oclyke/Neptune/hardware/hubble-lens/hubble-lens.kicad_pcb

## KiCad design hardware/hubble-lens/hubble-lens.kicad_pcb (2025-04-26)

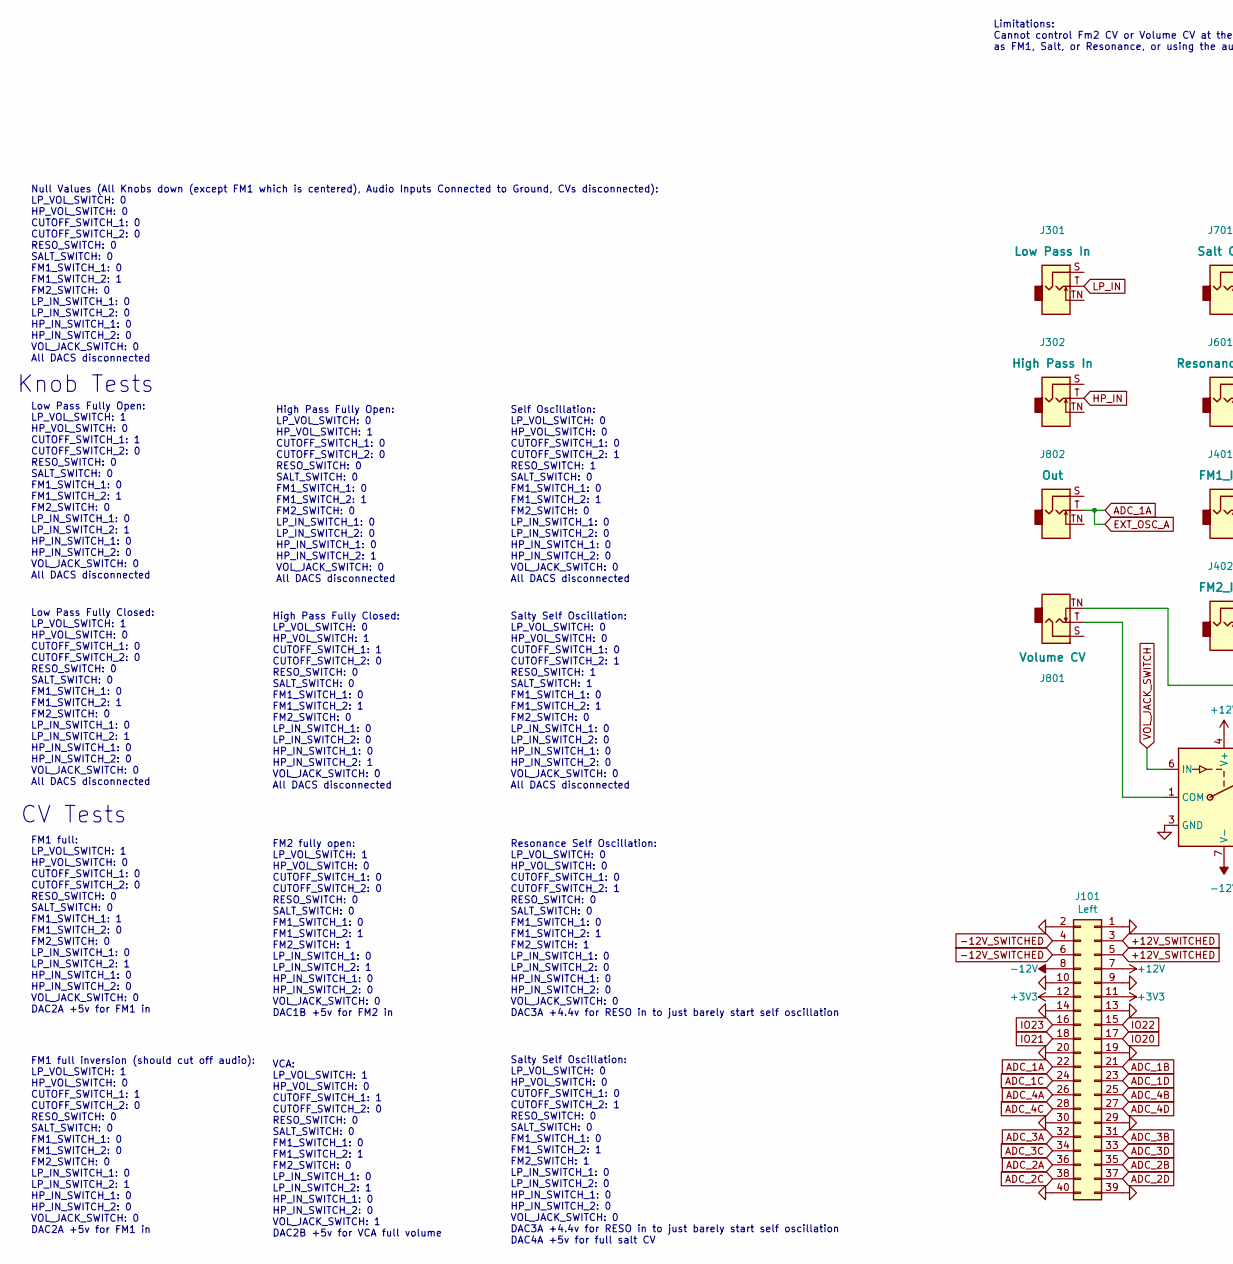
[picture p1: schematic hubble-lens.kicad_sch, Neptune: Hubble Lens, part in row 1, column 1]

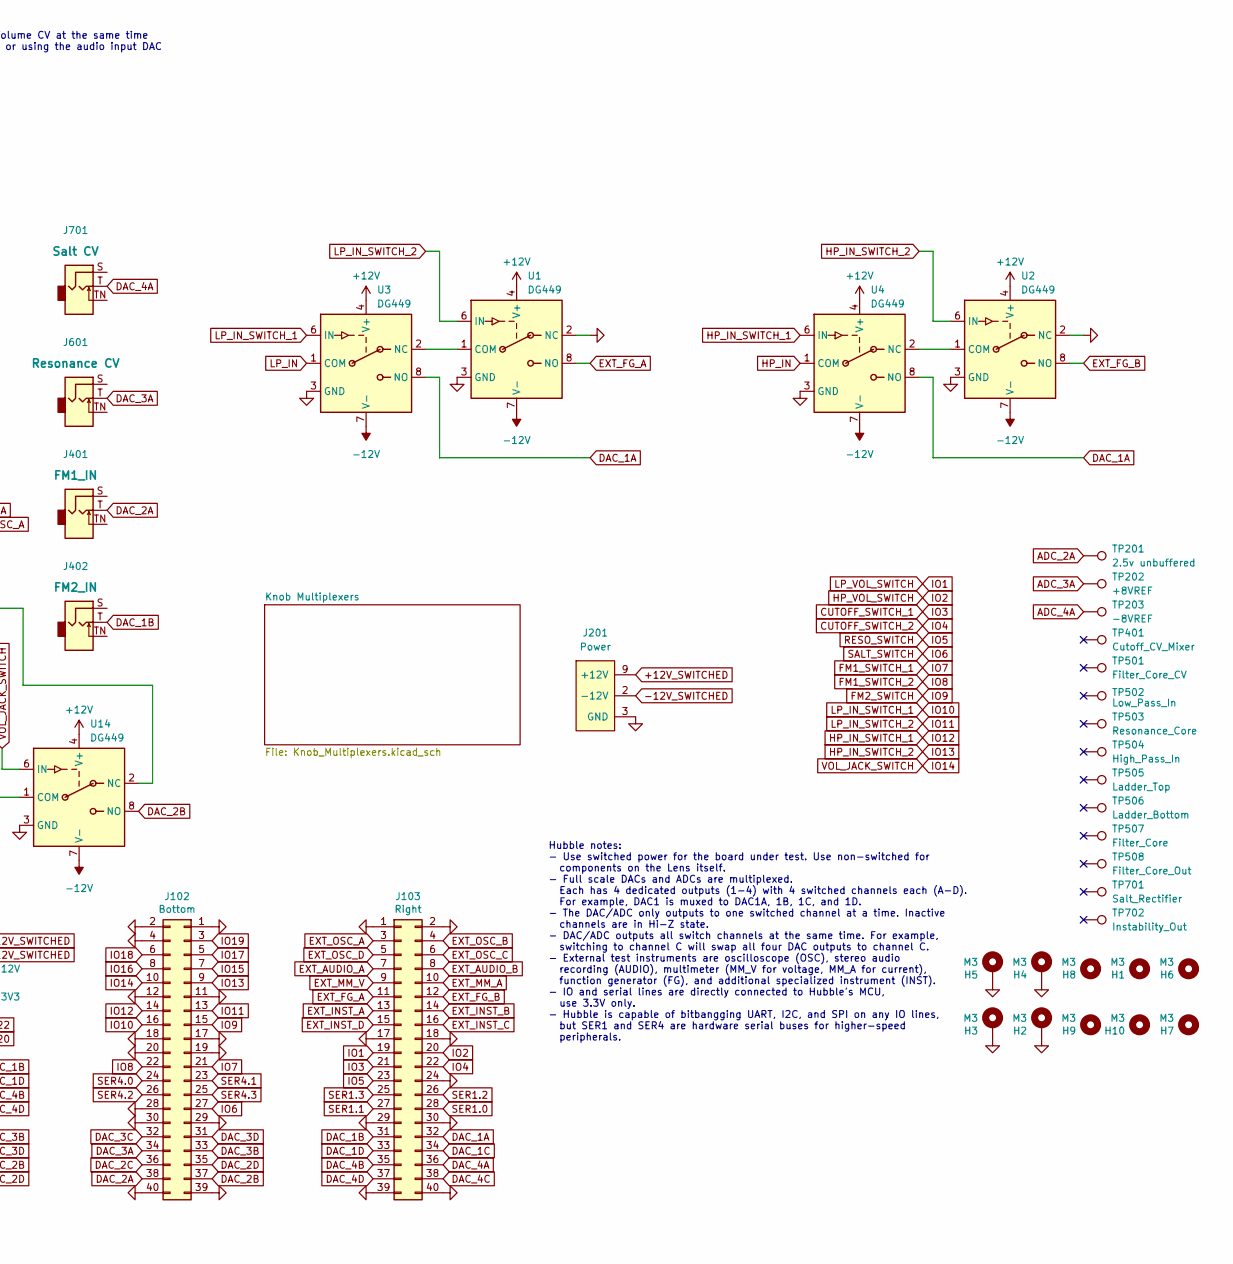
[picture p2: schematic hubble-lens.kicad_sch, Neptune: Hubble Lens, part in row 1, column 2]

Parts:
H1, H6, H7, H8, H9, H10: M3; MountingHole_3.2mm_M3
H2, H3, H4, H5: M3; MountingHole_3.2mm_M3_Pad_Via
J101: Left; PinSocket_2x20_P2.54mm_Vertical
J102: Bottom; PinSocket_2x20_P2.54mm_Vertical
J103: Right; PinSocket_2x20_P2.54mm_Vertical
J201: Power; Eurorack_Power_2x5_Shrouded_Lock; MPN 302-S101
J301, J302, J401, J402, J601, J701, J801, J802: AudioJack_WQP518MA_Compact_S; MPN WQP-WQP518MA
TP201, TP202, TP203, TP401, TP501, TP502, TP503, TP504, TP505, TP506, TP507, TP508, TP701, TP702: TestPoint_THTPad_D2.0mm_Drill1.0mm
U1, U2, U3, U4, U14: DG449; Vishay_SOT-23_8

Connections:
+3V3: J101.11, J101.12
+12V: J101.7, U1.4 (V+), U2.4 (V+), U3.4 (V+), U4.4 (V+), U14.4 (V+); also elsewhere on the board
+12V_SWITCHED: J101.3, J101.5, J201.9 (+12V), J201.10 (+12V)
-12V: J101.8, U1.7 (V-), U2.7 (V-), U3.7 (V-), U4.7 (V-), U14.7 (V-); also elsewhere on the board
-12V_SWITCHED: J101.4, J101.6, J201.1 (-12V), J201.2 (-12V)
ADC_1A: J101.22, J103.3, J802.T (Tip)
ADC_1B: J101.21
ADC_1C: J101.24
ADC_1D: J101.23
ADC_2A: J101.36, TP201.1
ADC_2B: J101.35
ADC_2C: J101.38
ADC_2D: J101.37
ADC_3A: J101.32, TP202.1
ADC_3B: J101.31
ADC_3C: J101.34
ADC_3D: J101.33
ADC_4A: J101.26, TP203.1
ADC_4B: J101.25
ADC_4C: J101.28
ADC_4D: J101.27
CUTOFF_SWITCH_1: J103.21; also elsewhere on the board
CUTOFF_SWITCH_2: J103.22; also elsewhere on the board
DAC_1A: J103.32, U3.8 (NO), U4.8 (NO)
DAC_1B: J103.31, J402.T (Tip)
DAC_1C: J103.34
DAC_1D: J103.33
DAC_2A: J102.38, J401.T (Tip)
DAC_2B: J102.37, U14.8 (NO)
DAC_2C: J102.36
DAC_2D: J102.35
DAC_3A: J102.34, J601.T (Tip)
DAC_3B: J102.33
DAC_3C: J102.32
DAC_3D: J102.31
DAC_4A: J103.36, J701.T (Tip)
DAC_4B: J103.35
DAC_4C: J103.38
DAC_4D: J103.37
EXT_AUDIO_A: J103.7
EXT_AUDIO_B: J103.8
EXT_FG_A: J103.11, U1.8 (NO)
EXT_FG_B: J103.12, U2.8 (NO)
EXT_INST_A: J103.13
EXT_INST_B: J103.14
EXT_INST_C: J103.16
EXT_INST_D: J103.15
EXT_MM_A: J103.10
EXT_MM_V: J103.9
EXT_OSC_B: J103.4
EXT_OSC_C: J103.6
EXT_OSC_D: J103.5
FM1_SWITCH_1: J102.21; also elsewhere on the board
FM1_SWITCH_2: J102.22; also elsewhere on the board
FM2_SWITCH: J102.15; also elsewhere on the board
GND: H2.1, H3.1, H4.1, H5.1, J101.1, J101.2, J101.9, J101.10, J101.13, J101.14, J101.19, J101.20, J101.29, J101.30, J101.39, J101.40, J102.1, J102.2, J102.4, J102.11, J102.12, J102.17, J102.18, J102.19, J102.20, J102.28, J102.29, J102.30, J102.39, J102.40, J103.1, J103.2, J103.17, J103.18, J103.24, J103.29, J103.30, J103.39, J103.40, J201.3 (GND), J201.4 (GND), J201.5 (GND), J201.6 (GND), J201.7 (GND), J201.8 (GND), U1.2 (NC), U1.3 (GND), U2.2 (NC), U2.3 (GND), U3.3 (GND), U4.3 (GND), U14.3 (GND); also elsewhere on the board
HP_IN: J302.T (Tip), U4.1 (COM)
HP_IN_SWITCH_1: J102.14, U4.6 (IN)
HP_IN_SWITCH_2: J102.9, U2.6 (IN)
HP_VOL_SWITCH: J103.20; also elsewhere on the board
IO1: J103.19; also elsewhere on the board
IO5: J103.23; also elsewhere on the board
IO6: J102.27; also elsewhere on the board
IO10: J102.16, U3.6 (IN)
IO11: J102.13, U1.6 (IN)
IO14: J102.10, U14.6 (IN)
IO15: J102.7
IO16: J102.8
IO17: J102.5
IO18: J102.6
IO19: J102.3
IO20: J101.17
IO21: J101.18
IO22: J101.15
IO23: J101.16
LP_IN: J301.T (Tip), U3.1 (COM)
unnamed: J801.T (Tip), U14.1 (COM)
unnamed: J801.TN (Tip_normalize), U14.2 (NC)
unnamed: U1.1 (COM), U3.2 (NC)
unnamed: U2.1 (COM), U4.2 (NC)
SER1.0: J103.28
SER1.1: J103.27
SER1.2: J103.26
SER1.3: J103.25
SER4.0: J102.24
SER4.1: J102.23
SER4.2: J102.26
SER4.3: J102.25

Notes on the sheet:
Null Values (All Knobs down (except FM1 which is centered), Audio Inputs Connected to Ground, CVs disconnected): LP_VOL_SWITCH: 0 HP_VOL_SWITCH: 0 CUTOFF_SWITCH_1: 0 CUTOFF_SWITCH_2: 0 RESO_SWITCH: 0 SALT_SWITCH: 0 FM1_SWITCH_1: 0 FM1_SWITCH_2: 1 FM2_SWITCH: 0 LP_IN_SWITCH_1: 0 LP_IN_SWITCH_2: 0 HP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
Self Oscillation: LP_VOL_SWITCH: 0 HP_VOL_SWITCH: 0 CUTOFF_SWITCH_1: 0 CUTOFF_SWITCH_2: 1 RESO_SWITCH: 1 SALT_SWITCH: 0 FM1_SWITCH_1: 0 FM1_SWITCH_2: 1 FM2_SWITCH: 0 LP_IN_SWITCH_1: 0 LP_IN_SWITCH_2: 0 HP_IN_SWITCH_1: 0 HP_IN_SWITCH_2: 0 VOL_JACK_SWITCH: 0 All DACS disconnected
Knob Tests
Limitations: Cannot control Fm2 CV or Volume CV at the same time as FM1, Salt, or Resonance, or using the audio input DAC
VCA: LP_VOL_SWITCH: 1 HP_VOL_SWITCH: 0 CUTOFF_SWITCH_1: 1 CUTOFF_SWITCH_2: 0 RESO_SWITCH: 0 SALT_SWITCH: 0 FM1_SWITCH_1: 0 FM1_SWITCH_2: 1 FM2_SWITCH: 0 LP_IN_SWITCH_1: 0 LP_IN_SWITCH_2: 1 HP_IN_SWITCH_1: 0 HP_IN_SWITCH_2: 0 VOL_JACK_SWITCH: 1 DAC2B +5v for VCA full volume
CV Tests
Salty Self Oscillation: LP_VOL_SWITCH: 0 HP_VOL_SWITCH: 0 CUTOFF_SWITCH_1: 0 CUTOFF_SWITCH_2: 1 RESO_SWITCH: 0 SALT_SWITCH: 0 FM1_SWITCH_1: 0 FM1_SWITCH_2: 1 FM2_SWITCH: 1 LP_IN_SWITCH_1: 0 LP_IN_SWITCH_2: 0 HP_IN_SWITCH_1: 0 HP_IN_SWITCH_2: 0 VOL_JACK_SWITCH: 0 DAC3A +4.4v for RESO in to just bare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
High Pass Fully Closed: LP_VOL_SWITCH: 0 HP_VOL_SWITCH: 1 CUTOFF_SWITCH_1: 1 CUTOFF_SWITCH_2: 0 RESO_SWITCH: 0 SALT_SWITCH: 0 FM1_SWITCH_1: 0 FM1_SWITCH_2: 1 FM2_SWITCH: 0 LP_IN_SWITCH_1: 0 LP_IN_SWITCH_2: 0 HP_IN_SWITCH_1: 0 HP_IN_SWITCH_2: 1 VOL_JACK_SWITCH: 0 All DACS disconnected
FM1 full inversion (should cut off audio): LP_VOL_SWITCH: 1 HP_VOL_SWITCH: 0 CUTOFF_SWITCH_1: 1 CUTOFF_SWITCH_2: 0 RESO_SWITCH: 0 SALT_SWITCH: 0 FM1_SWITCH_1: 0 FM1_SWITCH_2: 0 FM2_SWITCH: 0 LP_IN_SWITCH_1: 0 LP_IN_SWITCH_2: 1 HP_IN_SWITCH_1: 0 HP_IN_SWITCH_2: 0 VOL_JACK_SWITCH: 0 DAC2A +5v for FM1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
Hubble notes: - Use switched power for the board under test. Use non-switched for components on the Lens itself. - Full scale DACs and ADCs are multiplexed. Each has 4 dedicated outputs (1-4) with 4 switched channels each (A-D). For example, DAC1 is muxed to DAC1A, 1B, 1C, and 1D. - The DAC/ADC onl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
FM2 fully open: LP_VOL_SWITCH: 1 HP_VOL_SWITCH: 0 CUTOFF_SWITCH_1: 0 CUTOFF_SWITCH_2: 0 RESO_SWITCH: 0 SALT_SWITCH: 0 FM1_SWITCH_1: 0 FM1_SWITCH_2: 1 FM2_SWITCH: 1 LP_IN_SWITCH_1: 0 LP_IN_SWITCH_2: 1 HP_IN_SWITCH_1: 0 HP_IN_SWITCH_2: 0 VOL_JACK_SWITCH: 0 DAC1B +5v for FM2 in
Low Pass Fully Closed: LP_VOL_SWITCH: 1 HP_VOL_SWITCH: 0 CUTOFF_SWITCH_1: 0 CUTOFF_SWITCH_2: 0 RESO_SWITCH: 0 SALT_SWITCH: 0 FM1_SWITCH_1: 0 FM1_SWITCH_2: 1 FM2_SWITCH: 0 LP_IN_SWITCH_1: 0 LP_IN_SWITCH_2: 1 HP_IN_SWITCH_1: 0 HP_IN_SWITCH_2: 0 VOL_JACK_SWITCH: 0 All DACS disconnected
FM1 full: LP_VOL_SWITCH: 1 HP_VOL_SWITCH: 0 CUTOFF_SWITCH_1: 0 CUTOFF_SWITCH_2: 0 RESO_SWITCH: 0 SALT_SWITCH: 0 FM1_SWITCH_1: 1 FM1_SWITCH_2: 0 FM2_SWITCH: 0 LP_IN_SWITCH_1: 0 LP_IN_SWITCH_2: 1 HP_IN_SWITCH_1: 0 HP_IN_SWITCH_2: 0 VOL_JACK_SWITCH: 0 DAC2A +5v for FM1 in
Low Pass Fully Open: LP_VOL_SWITCH: 1 HP_VOL_SWITCH: 0 CUTOFF_SWITCH_1: 1 CUTOFF_SWITCH_2: 0 RESO_SWITCH: 0 SALT_SWITCH: 0 FM1_SWITCH_1: 0 FM1_SWITCH_2: 1 FM2_SWITCH: 0 LP_IN_SWITCH_1: 0 LP_IN_SWITCH_2: 1 HP_IN_SWITCH_1: 0 HP_IN_SWITCH_2: 0 VOL_JACK_SWITCH: 0 All DACS disconnected
Salty Self Oscillation: LP_VOL_SWITCH: 0 HP_VOL_SWITCH: 0 CUTOFF_SWITCH_1: 0 CUTOFF_SWITCH_2: 1 RESO_SWITCH: 1 SALT_SWITCH: 1 FM1_SWITCH_1: 0 FM1_SWITCH_2: 1 FM2_SWITCH: 0 LP_IN_SWITCH_1: 0 LP_IN_SWITCH_2: 0 HP_IN_SWITCH_1: 0 HP_IN_SWITCH_2: 0 VOL_JACK_SWITCH: 0 All DACS disconnected
High Pass Fully Open: LP_VOL_SWITCH: 0 HP_VOL_SWITCH: 1 CUTOFF_SWITCH_1: 0 CUTOFF_SWITCH_2: 0 RESO_SWITCH: 0 SALT_SWITCH: 0 FM1_SWITCH_1: 0 FM1_SWITCH_2: 1 FM2_SWITCH: 0 LP_IN_SWITCH_1: 0 LP_IN_SWITCH_2: 0 HP_IN_SWITCH_1: 0 HP_IN_SWITCH_2: 1 VOL_JACK_SWITCH: 0 All DACS disconnected
Resonance Self Oscillation: LP_VOL_SWITCH: 0 HP_VOL_SWITCH: 0 CUTOFF_SWITCH_1: 0 CUTOFF_SWITCH_2: 1 RESO_SWITCH: 0 SALT_SWITCH: 0 FM1_SWITCH_1: 0 FM1_SWITCH_2: 1 FM2_SWITCH: 1 LP_IN_SWITCH_1: 0 LP_IN_SWITCH_2: 0 HP_IN_SWITCH_1: 0 HP_IN_SWITCH_2: 0 VOL_JACK_SWITCH: 0 DAC3A +4.4v for RESO in to just 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

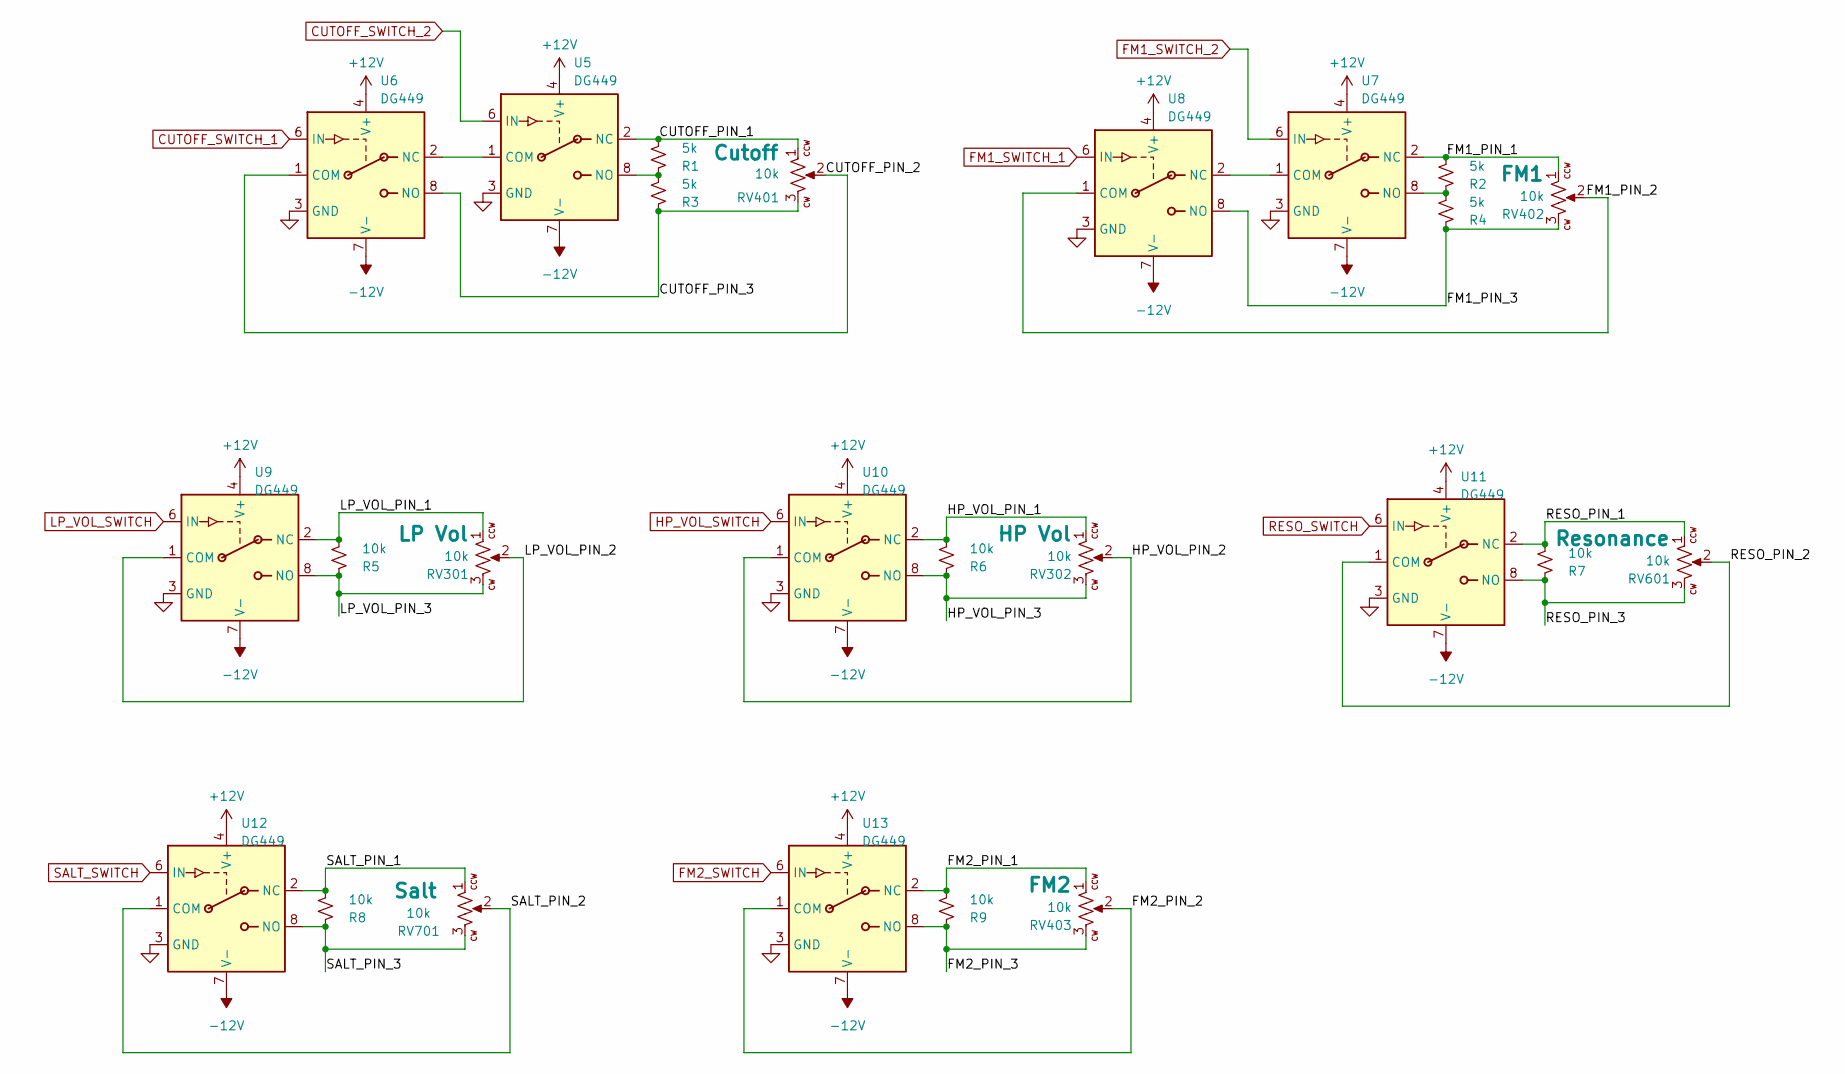
[picture p3: schematic Knob_Multiplexers.kicad_sch]

Parts:
R1, R2, R3, R4: 5k; R_0603_HandSolder
R5, R6, R7, R8, R9: 10k; R_0603_HandSolder
RV301, RV302, RV401, RV402, RV403, RV601, RV701: 10k; Potentiometer_Alpha_R0904N; Rating B10k
U5, U6, U7, U8, U9, U10, U11, U12, U13: DG449; Vishay_SOT-23_8

Connections:
+12V: U5.4 (V+), U6.4 (V+), U7.4 (V+), U8.4 (V+), U9.4 (V+), U10.4 (V+), U11.4 (V+), U12.4 (V+), U13.4 (V+); also elsewhere on the board
-12V: U5.7 (V-), U6.7 (V-), U7.7 (V-), U8.7 (V-), U9.7 (V-), U10.7 (V-), U11.7 (V-), U12.7 (V-), U13.7 (V-); also elsewhere on the board
/Knob Multiplexers/CUTOFF_PIN_1: R1.2, RV401.1, U5.2 (NC)
/Knob Multiplexers/CUTOFF_PIN_2: RV401.2, U6.1 (COM)
/Knob Multiplexers/CUTOFF_PIN_3: R3.1, RV401.3, U6.8 (NO)
/Knob Multiplexers/FM1_PIN_1: R2.2, RV402.1, U7.2 (NC)
/Knob Multiplexers/FM1_PIN_2: RV402.2, U8.1 (COM)
/Knob Multiplexers/FM1_PIN_3: R4.1, RV402.3, U8.8 (NO)
/Knob Multiplexers/FM2_PIN_1: R9.2, RV403.1, U13.2 (NC)
/Knob Multiplexers/FM2_PIN_2: RV403.2, U13.1 (COM)
/Knob Multiplexers/FM2_PIN_3: R9.1, RV403.3, U13.8 (NO)
/Knob Multiplexers/HP_VOL_PIN_1: R6.2, RV302.1, U10.2 (NC)
/Knob Multiplexers/HP_VOL_PIN_2: RV302.2, U10.1 (COM)
/Knob Multiplexers/HP_VOL_PIN_3: R6.1, RV302.3, U10.8 (NO)
/Knob Multiplexers/LP_VOL_PIN_1: R5.2, RV301.1, U9.2 (NC)
/Knob Multiplexers/LP_VOL_PIN_2: RV301.2, U9.1 (COM)
/Knob Multiplexers/LP_VOL_PIN_3: R5.1, RV301.3, U9.8 (NO)
/Knob Multiplexers/RESO_PIN_1: R7.2, RV601.1, U11.2 (NC)
/Knob Multiplexers/RESO_PIN_2: RV601.2, U11.1 (COM)
/Knob Multiplexers/RESO_PIN_3: R7.1, RV601.3, U11.8 (NO)
/Knob Multiplexers/SALT_PIN_1: R8.2, RV701.1, U12.2 (NC)
/Knob Multiplexers/SALT_PIN_2: RV701.2, U12.1 (COM)
/Knob Multiplexers/SALT_PIN_3: R8.1, RV701.3, U12.8 (NO)
CUTOFF_SWITCH_1: U6.6 (IN); also elsewhere on the board
CUTOFF_SWITCH_2: U5.6 (IN); also elsewhere on the board
FM1_SWITCH_1: U8.6 (IN); also elsewhere on the board
FM1_SWITCH_2: U7.6 (IN); also elsewhere on the board
FM2_SWITCH: U13.6 (IN); also elsewhere on the board
GND: U5.3 (GND), U6.3 (GND), U7.3 (GND), U8.3 (GND), U9.3 (GND), U10.3 (GND), U11.3 (GND), U12.3 (GND), U13.3 (GND); also elsewhere on the board
HP_VOL_SWITCH: U10.6 (IN); also elsewhere on the board
IO1: U9.6 (IN); also elsewhere on the board
IO5: U11.6 (IN); also elsewhere on the board
IO6: U12.6 (IN); also elsewhere on the board
unnamed: U5.1 (COM), U6.2 (NC)
unnamed: R1.1, R3.2, U5.8 (NO)
unnamed: U7.1 (COM), U8.2 (NC)
unnamed: R2.1, R4.2, U7.8 (NO)

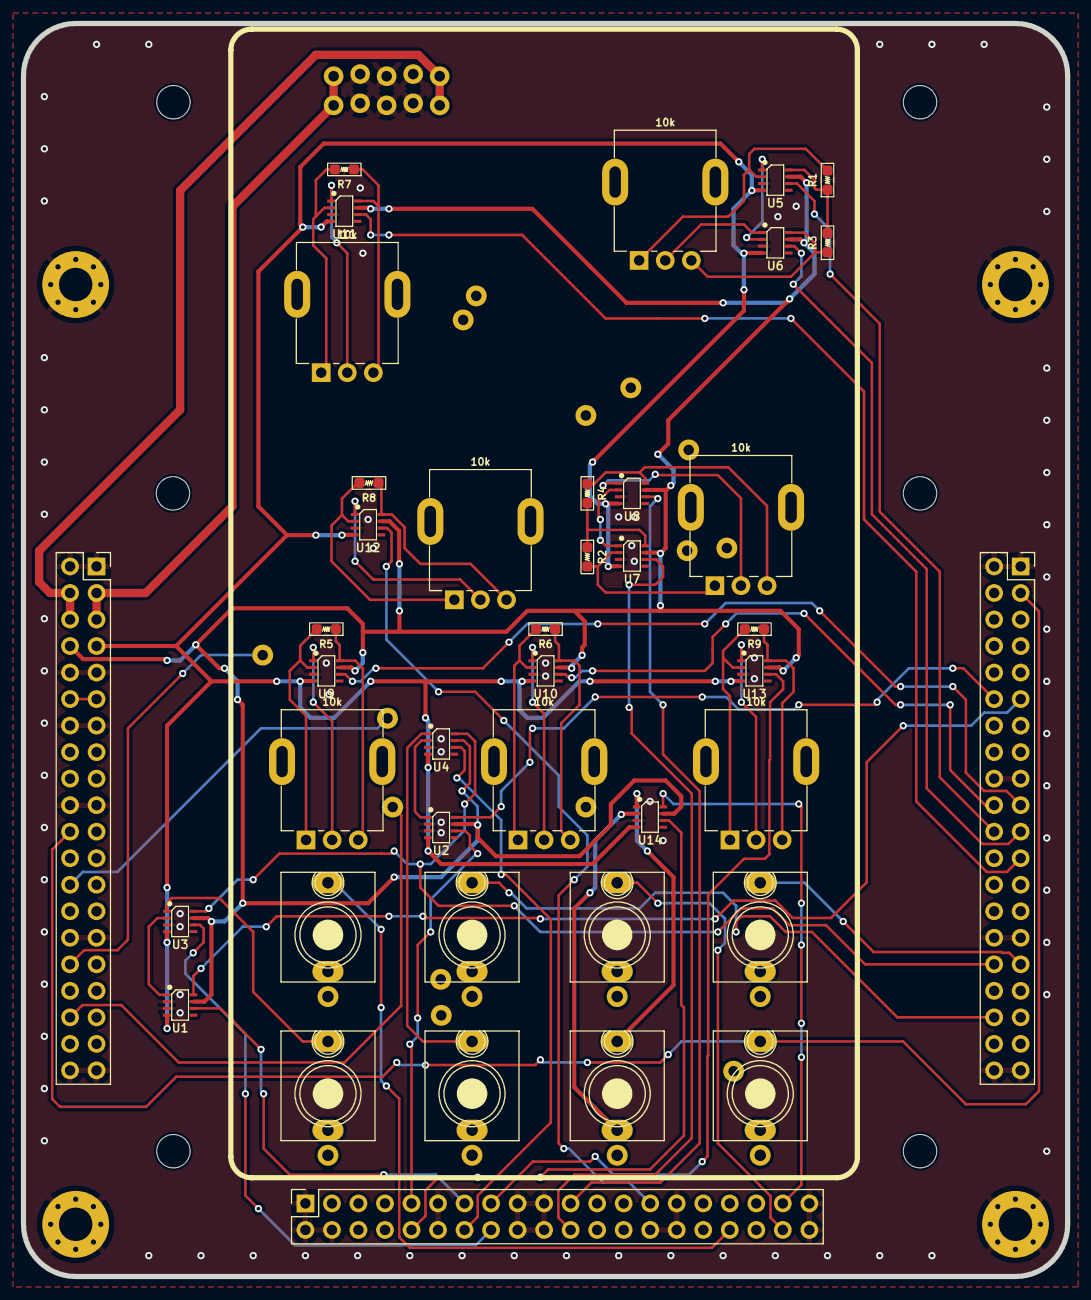
[picture p4: board hubble-lens.kicad_pcb from above]

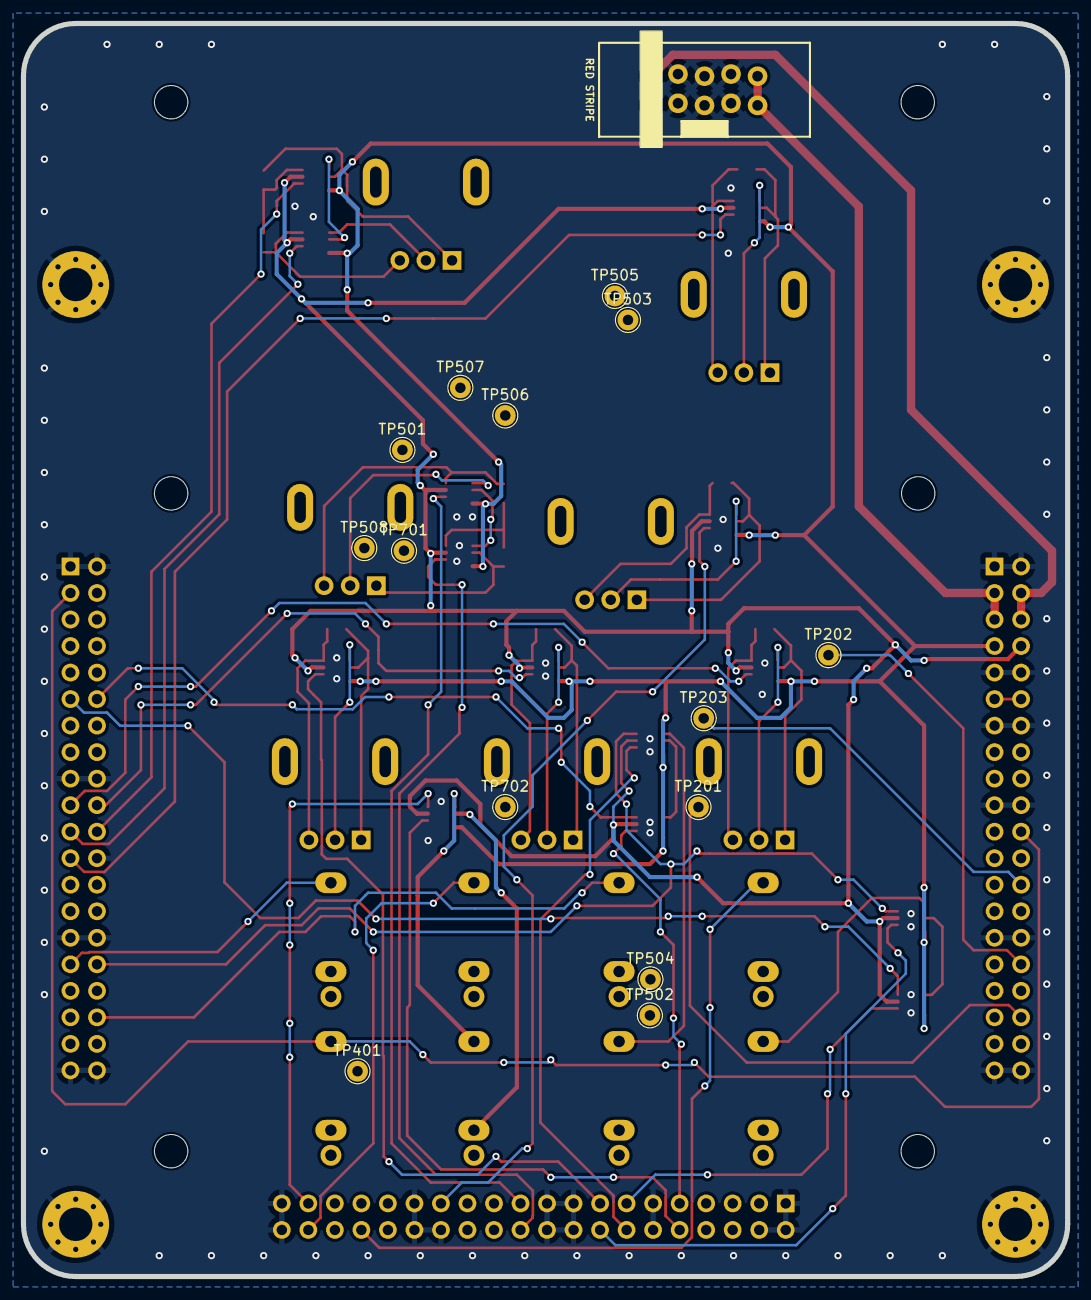
[picture p5: board hubble-lens.kicad_pcb from below]

Board: 2 copper layers, 100.0 x 120.0 mm, 66 parts (15 on the bottom side), 63 nets.
