oclyke/Neptune/(commit log)

2025-04-26 update board to kicad 9
    [Cutoff_CV_Driver.kicad_sch, Filter_Core.kicad_sch, Input_Drivers.kicad_sch, LED_Drivers.kicad_sch, Output_VCA.kicad_sch, Power.kicad_sch, Resonance_VCA.kicad_sch, Salt_VCA.kicad_sch]
2025-04-26 update faceplate to kicad 9
    [faceplate.kicad_pcb]
2025-04-26 update hubble-lens to kicad 9
    [Knob_Multiplexers.kicad_sch, hubble-lens.kicad_pcb, hubble-lens.kicad_sch]
2025-04-26 update winterbloom worksheet layout template to kicad 9
2025-04-27 add nix hardware dev env and bom tool
2025-05-02 remove test points from BOM
    [Cutoff_CV_Driver.kicad_sch, Filter_Core.kicad_sch, Power.kicad_sch, Salt_VCA.kicad_sch]
