oclyke/Neptune/(notices)

Notices in the files:
hardware/board/Output_VCA.kicad_sch:
CERN-OHL-P v2
hardware/board/mainboard.kicad_sch:
Open-source hardware under CERN-OHL-P V2
hardware/faceplate/faceplate.kicad_pcb:
CC BY-NC-ND 4.0
